oxplot/splapr/Readme.md

This project is in alpha stage. See https://splapr.com for more info.
