oxplot/splapr/website/content/menu/index.md

---
headless: true
---

- [**Introduction**]({{< relref "/" >}})
- [Gallery]({{<relref "/gallery">}})
- [Code](https://github.com/oxplot/splapr)
- [CAD](https://cad.onshape.com/documents/07b74601fb852d69124aed33)
