oxplot/splapr/website/content/gallery.md

---
title: "Gallery"
type: docs
---

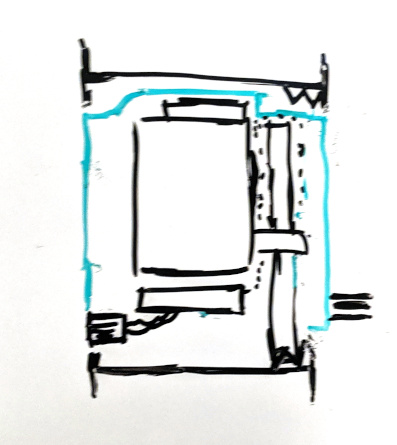
[picture p1: website/static/media/gallery_1.jpg]

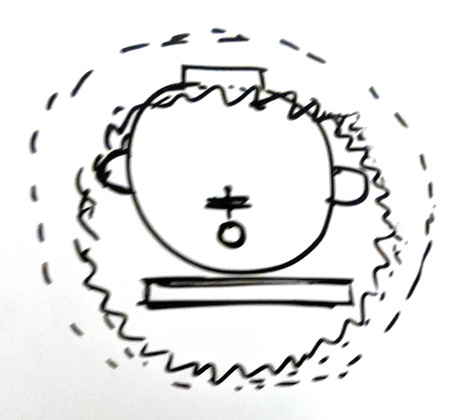
[picture p2: website/static/media/gallery_2.jpg]

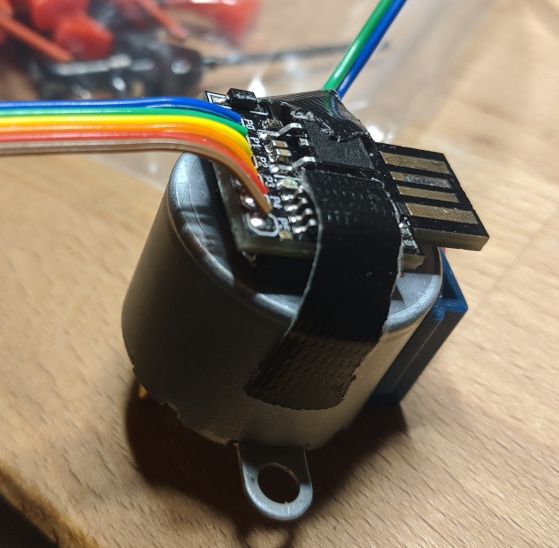
[picture p3: website/static/media/gallery_3.jpg]

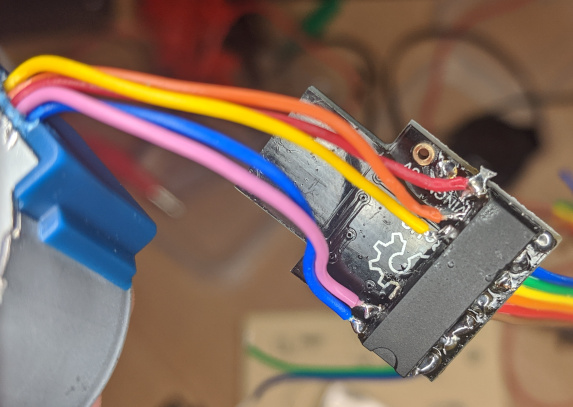
[picture p4: website/static/media/gallery_4.jpg]

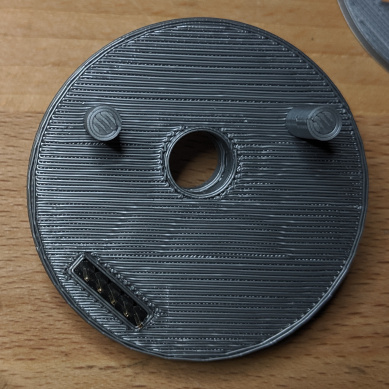
[picture p5: website/static/media/gallery_5.jpg]

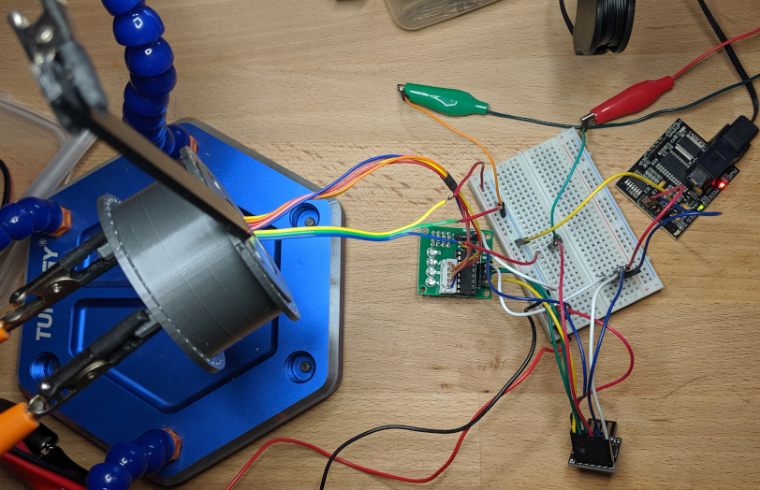
[picture p6: website/static/media/gallery_6.jpg]

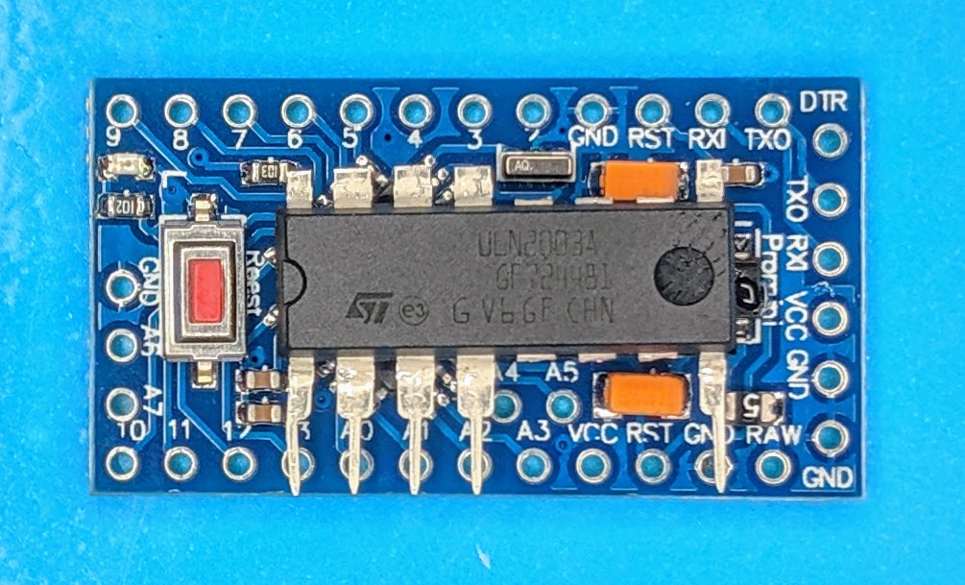
[picture p7: website/static/media/gallery_7.jpg]

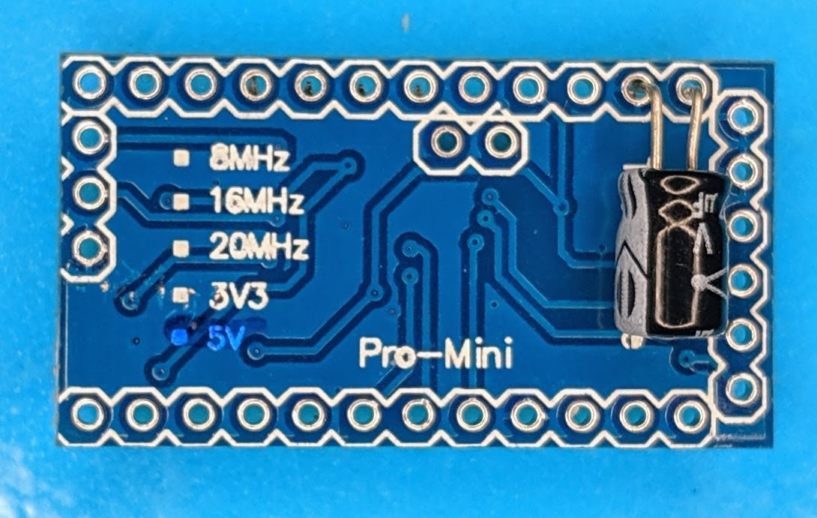
[picture p8: website/static/media/gallery_8.jpg]

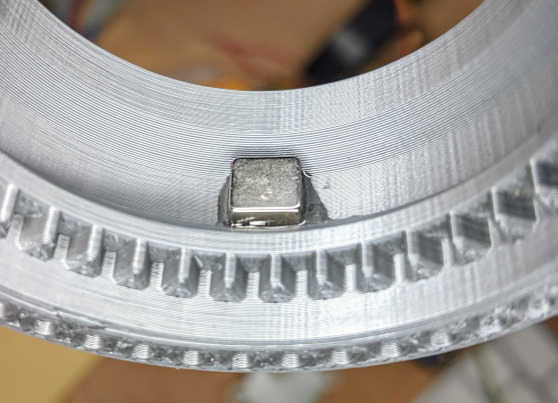
[picture p9: website/static/media/gallery_9.jpg]

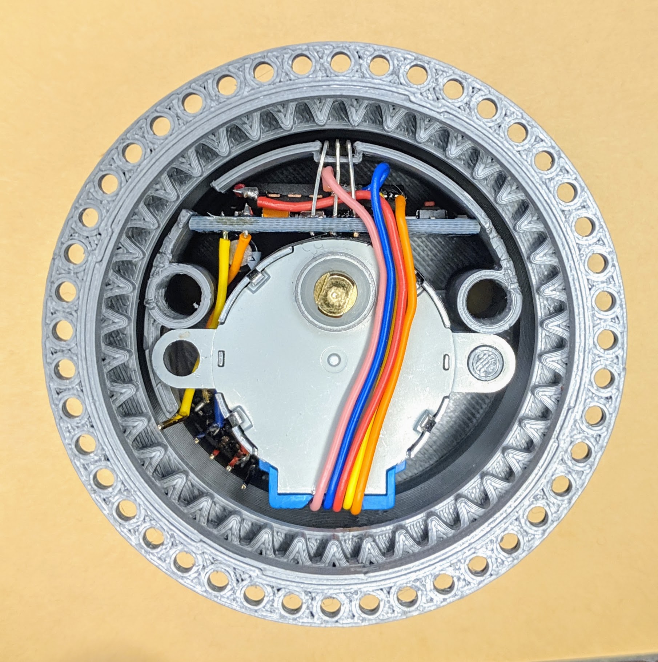
[picture p10: website/static/media/gallery_10.jpg]

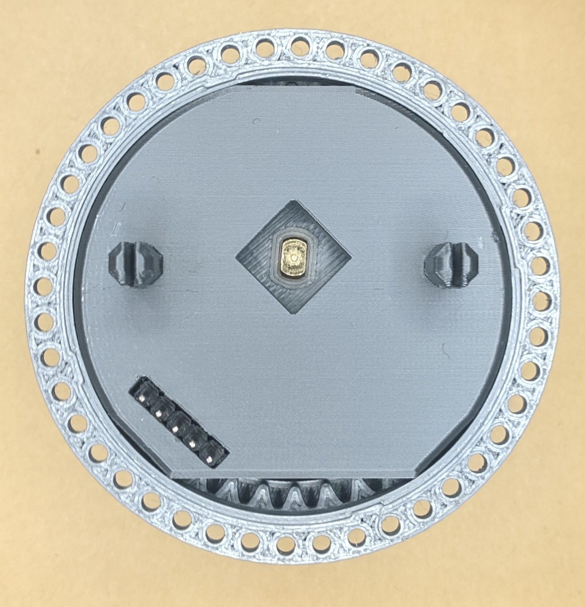
[picture p11: website/static/media/gallery_11.jpg]
