oxplot/splapr/(commit log)

2019-08-18 Some pin change ups and power savings
2019-08-19 More work
    [micronucleus.cfg]
